beel1/RASCSI/src/rascsi152/doc/fullspec.png

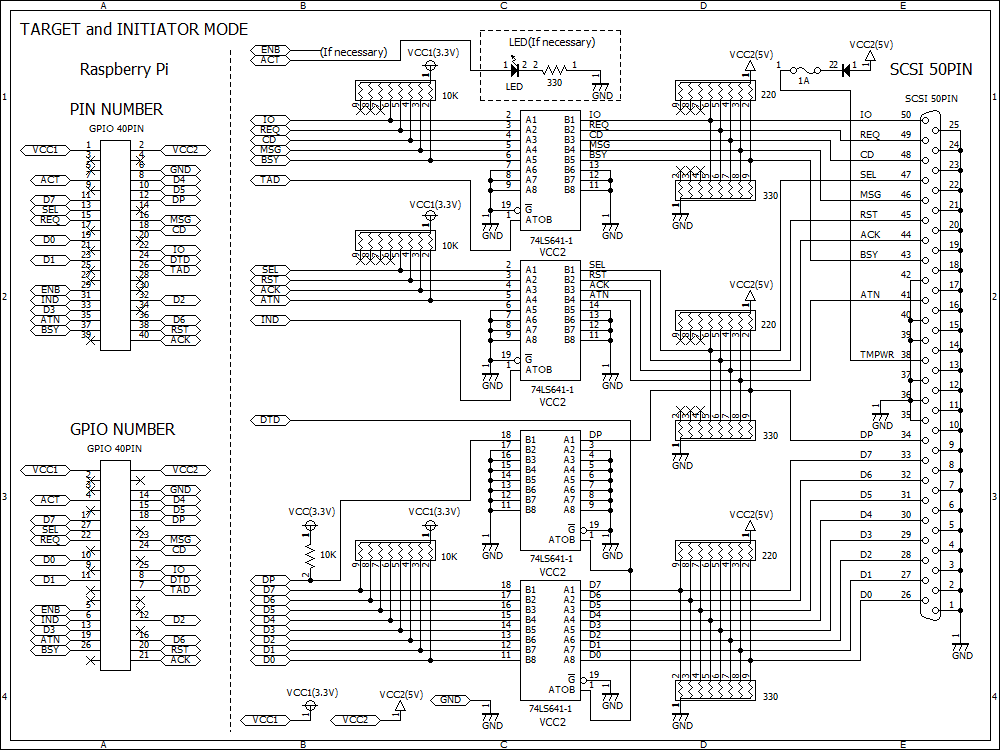
src/rascsi152/doc/fullspec.png
