beel1/RASCSI/src/rascsi152/doc/pinassign.png

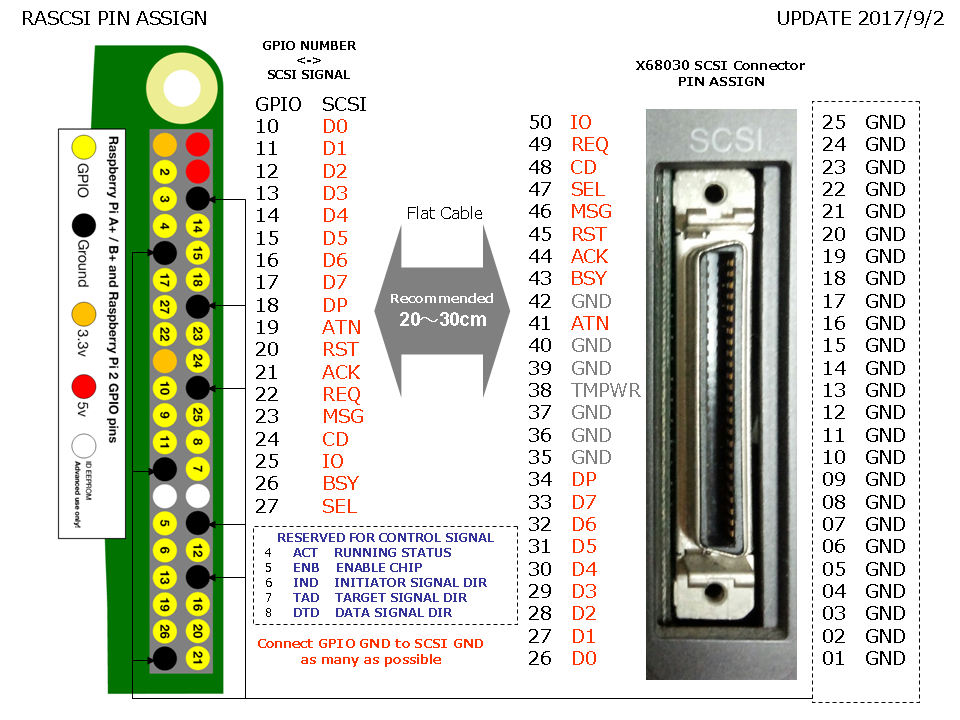
src/rascsi152/doc/pinassign.png
