beel1/RASCSI/src/rascsi152/doc/target.png

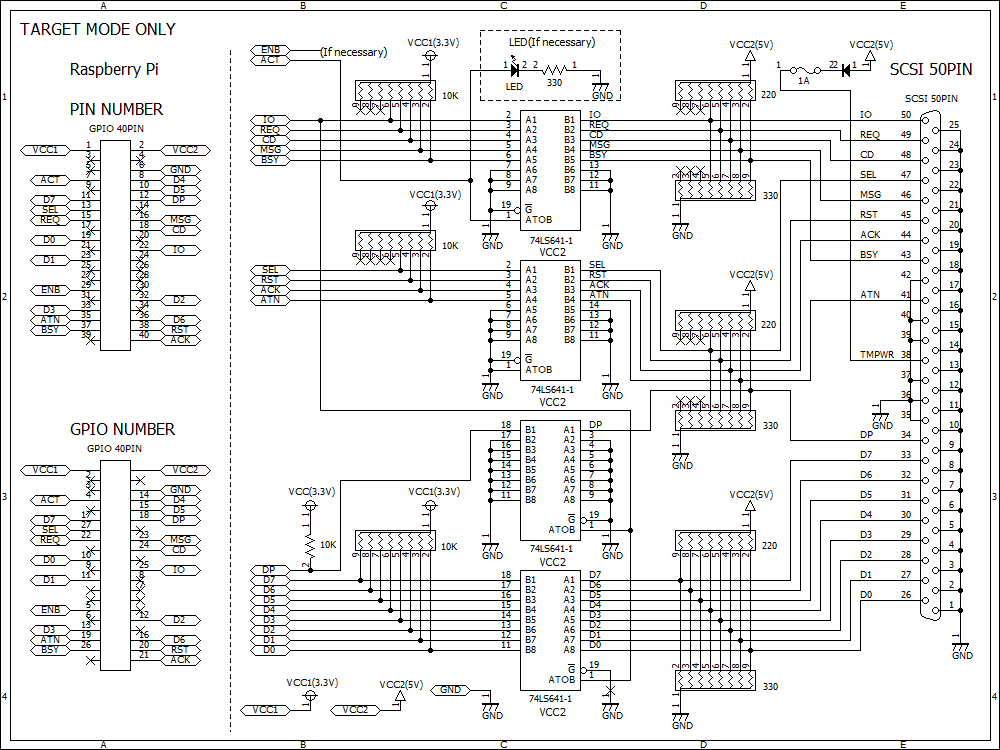
src/rascsi152/doc/target.png
