beel1/RASCSI/hw/rascsi_CN50_IDC50/rascsi_din.pdf

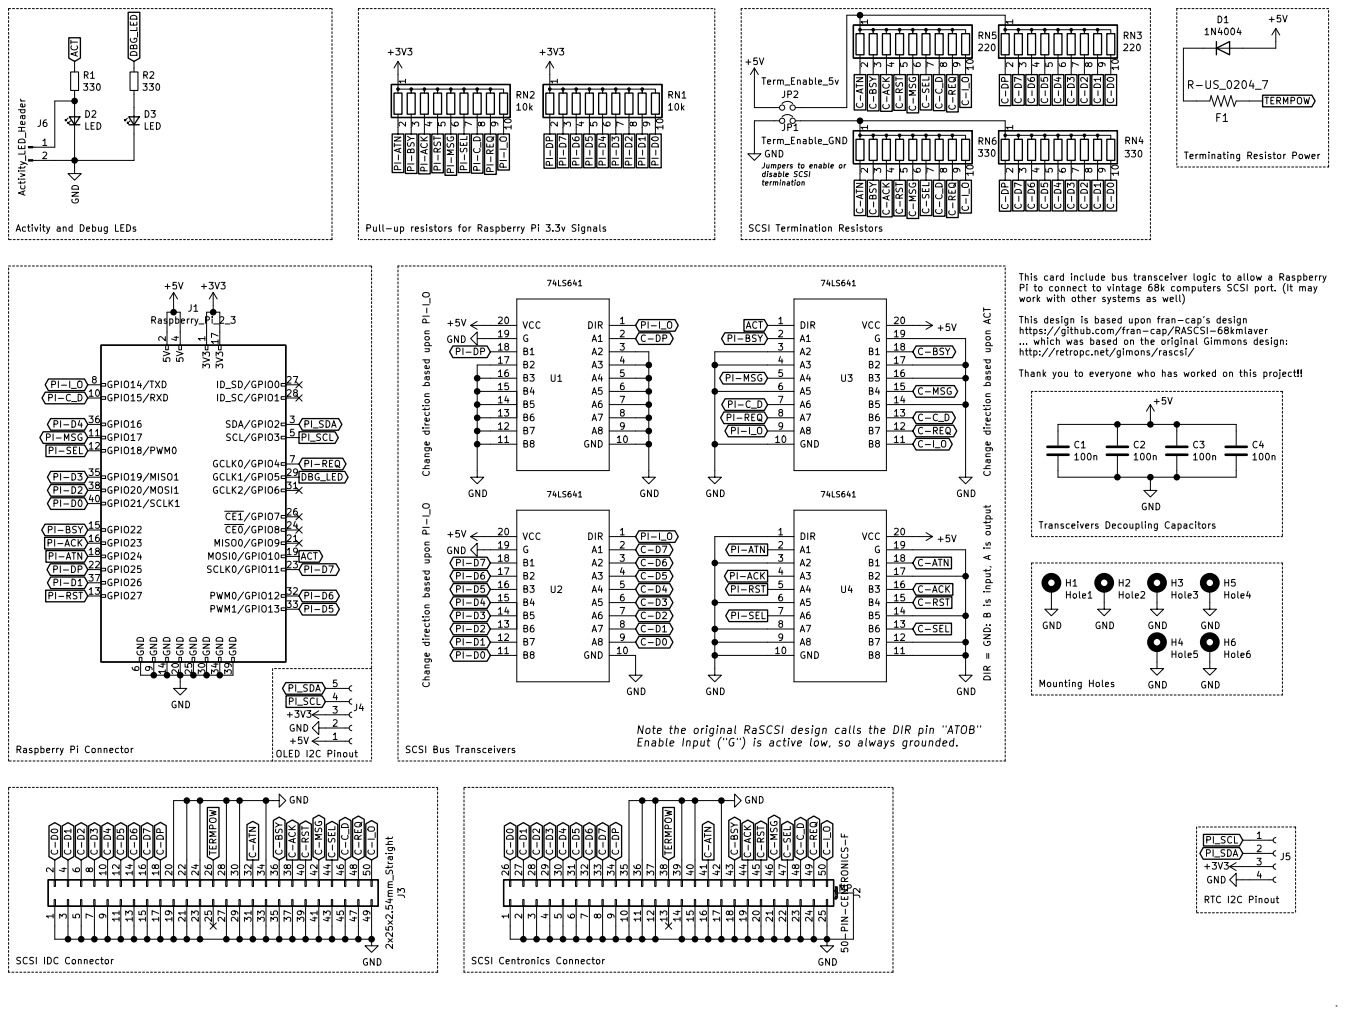
[picture p4: page 1]

Terminating Resistor Power Jumpers to enable or disable SCSI

Activity and Debug LEDs

This card include bus transceiver logic to allow a Raspberry
Pi to connect to vintage 68k computers SCSI port. (It may
work with other systems as well)

This design is based upon fran-cap's design
https://github.com/fran-cap/RASCSI-68kmlaver
... which was based on the original Gimmons design:
http://retropc.net/gimons/rascsi/

PI-MSG
ACT PI-SEL PI-ATN

Note the original RaSCSI design calls the DIR pin "ATOB"
