beel1/RASCSI/src/rascsi152/src/raspberrypi/disk.h

#define disk_h
#define DEFAULT_VERSION	RASCSI			// INQUERYのバージョン番号
#define DEFAULT_VENDER	"RASCSI"		// INQUERYのベンダ名
#define USE_LOG_OUTPUT	1				// 1:printf出力
#define USE_WAIT_CTRL	1				// 1:タイミング調整有効
#define USE_BURST_BUS	1				// 1:データバースト送受信有効
#define USE_SYNC_TRANS	0				// 1:同期転送有効
#define USE_MZ1F23_1024_SUPPORT		1	// 1:MZ-1F23(20M/セクタサイズ1024)
#define REMOVE_FIXED_SASIHD_SIZE	1	// 1:SASIHDのサイズ固定制限を解除する
#define BRIDGE_PRODUCT	"RASCSI BRIDGE"	// ブリッジデバイスの製品名
#include "filepath.h"
#include "fileio.h"
class Log
{
public:
	enum loglevel {
		Detail,							// 詳細レベル
		Normal,							// 通常レベル
		Warning,						// 警告レベル
		Debug							// デバッグレベル
	};
};
class BUS
{
public:
	enum phase_t {
		busfree,						// バスフリーフェーズ
		arbitration,					// アービトレーションフェーズ
		selection,						// セレクションフェーズ
		reselection,					// リセレクションフェーズ
		command,						// コマンドフェーズ
		execute,						// 実行フェーズ
		datain,							// データイン
		dataout,						// データアウト
		status,							// ステータスフェーズ
		msgin,							// メッセージフェーズ
		msgout,							// メッセージアウトフェーズ
		reserved						// 未使用/リザーブ
	};
	virtual BOOL FASTCALL Init() = 0;
	virtual void FASTCALL Reset() = 0;
	virtual void FASTCALL Cleanup() = 0;
	phase_t FASTCALL GetPhase()
	{
		DWORD mci;
		ASSERT(this);
		if (GetSEL()) {
			return selection;
		}
		if (!GetBSY()) {
			return busfree;
		}
		mci = GetMSG() ? 0x04 : 0x00;
		mci |= GetCD() ? 0x02 : 0x00;
		mci |= GetIO() ? 0x01 : 0x00;
		return Mci2Phase(mci);
	}
	static phase_t FASTCALL Mci2Phase(DWORD mci)
	{
		static const phase_t phase_table[8] =
		{
			dataout,
			datain,
			command,
			status,
			reserved,
			reserved,
			msgout,
			msgin
		};
		return phase_table[mci];
	}
	virtual DWORD FASTCALL Aquire() const = 0;
	virtual BOOL FASTCALL GetBSY() const = 0;
	virtual void FASTCALL SetBSY(BOOL ast) = 0;
	virtual BOOL FASTCALL GetSEL() const = 0;
	virtual void FASTCALL SetSEL(BOOL ast) = 0;
	virtual BOOL FASTCALL GetATN() const = 0;
	virtual void FASTCALL SetATN(BOOL ast) = 0;
	virtual BOOL FASTCALL GetACK() const = 0;
	virtual void FASTCALL SetACK(BOOL ast) = 0;
	virtual BOOL FASTCALL GetRST() const = 0;
	virtual void FASTCALL SetRST(BOOL ast) = 0;
	virtual BOOL FASTCALL GetMSG() const = 0;
	virtual void FASTCALL SetMSG(BOOL ast) = 0;
	virtual BOOL FASTCALL GetCD() const = 0;
	virtual void FASTCALL SetCD(BOOL ast) = 0;
	virtual BOOL FASTCALL GetIO() const = 0;
	virtual void FASTCALL SetIO(BOOL ast) = 0;
	virtual BOOL FASTCALL GetREQ() const = 0;
	virtual void FASTCALL SetREQ(BOOL ast) = 0;
	virtual BYTE FASTCALL GetDAT() const = 0;
	virtual void FASTCALL SetDAT(BYTE dat) = 0;
	virtual BOOL FASTCALL GetDP() const = 0;
#if USE_BURST_BUS == 1
	virtual int FASTCALL CommandHandShake(BYTE *buf) = 0;
	virtual int FASTCALL SendHandShake(
		BYTE *buf, int len, int syncoffset = 0) = 0;
	virtual int FASTCALL ReceiveHandShake(
		BYTE *buf, int len, int syncoffset = 0) = 0;
#endif	// USE_BURST_BUS
};
#define DISK_NOERROR		0x00000000	// NO ADDITIONAL SENSE INFO.
#define DISK_DEVRESET		0x00062900	// POWER ON OR RESET OCCURED
#define DISK_NOTREADY		0x00023a00	// MEDIUM NOT PRESENT
#define DISK_ATTENTION		0x00062800	// MEDIUM MAY HAVE CHANGED
#define DISK_PREVENT		0x00045302	// MEDIUM REMOVAL PREVENTED
#define DISK_READFAULT		0x00031100	// UNRECOVERED READ ERROR
#define DISK_WRITEFAULT		0x00030300	// PERIPHERAL DEVICE WRITE FAULT
#define DISK_WRITEPROTECT	0x00042700	// WRITE PROTECTED
#define DISK_MISCOMPARE		0x000e1d00	// MISCOMPARE DURING VERIFY
#define DISK_INVALIDCMD		0x00052000	// INVALID COMMAND OPERATION CODE
#define DISK_INVALIDLBA		0x00052100	// LOGICAL BLOCK ADDR. OUT OF RANGE
#define DISK_INVALIDCDB		0x00052400	// INVALID FIELD IN CDB
#define DISK_INVALIDLUN		0x00052500	// LOGICAL UNIT NOT SUPPORTED
#define DISK_INVALIDPRM		0x00052600	// INVALID FIELD IN PARAMETER LIST
#define DISK_INVALIDMSG		0x00054900	// INVALID MESSAGE ERROR
#define DISK_PARAMLEN		0x00051a00	// PARAMETERS LIST LENGTH ERROR
#define DISK_PARAMNOT		0x00052601	// PARAMETERS NOT SUPPORTED
#define DISK_PARAMVALUE		0x00052602	// PARAMETERS VALUE INVALID
#define DISK_PARAMSAVE		0x00053900	// SAVING PARAMETERS NOT SUPPORTED
#define DISK_NODEFECT		0x00010000	// DEFECT LIST NOT FOUND
class Disk;
class DiskTrack
{
public:
	enum {
		NumSectors = 32					// トラック毎のセクタ数
	};
	typedef struct {
		int track;						// トラックナンバー
		int size;						// セクタサイズ(8 or 9)
		int sectors;					// セクタ数(<=0x100)
		DWORD length;					// データバッファ長
		BYTE *buffer;					// データバッファ
		BOOL init;						// ロード済みか
		BOOL changed;					// 変更済みフラグ
		DWORD maplen;					// 変更済みマップ長
		BOOL *changemap;				// 変更済みマップ
		BOOL raw;						// RAWモード
		off64_t imgoffset;				// 実データまでのオフセット
	} disktrk_t;
public:
	DiskTrack();
	virtual ~DiskTrack();
	void FASTCALL Init(
		Disk *p, int track, int size, int sectors,
		BOOL raw = FALSE, off64_t imgoff = 0);
	BOOL FASTCALL Load();
	BOOL FASTCALL Save();
	BOOL FASTCALL Read(BYTE *buf, int sec) const;
	BOOL FASTCALL Write(const BYTE *buf, int sec);
	int FASTCALL GetTrack() const		{ return dt.track; }
	BOOL FASTCALL IsChanged() const		{ return dt.changed; }
private:
	Disk *disk;
	disktrk_t dt;
};
class DiskCache
{
public:
	typedef struct {
		DiskTrack *disktrk;				// 割り当てトラック
		DWORD serial;					// 最終シリアル
	} cache_t;
	enum {
		CacheMax = 16
	};
public:
	DiskCache(Disk *p, int size, int blocks, off64_t imgoff = 0);
	virtual ~DiskCache();
	void FASTCALL SetRawMode(BOOL raw);
	BOOL FASTCALL Save();
	BOOL FASTCALL Read(BYTE *buf, int block);
	BOOL FASTCALL Write(const BYTE *buf, int block);
	BOOL FASTCALL GetCache(int index, int& track, DWORD& serial) const;
private:
	void FASTCALL Clear();
	DiskTrack* FASTCALL Assign(int track);
	BOOL FASTCALL Load(int index, int track, DiskTrack *disktrk = NULL);
	void FASTCALL Update();
	Disk *disk;
	cache_t cache[CacheMax];
	DWORD serial;
	int sec_size;
	int sec_blocks;
	BOOL cd_raw;
	off64_t imgoffset;
};
class Disk
{
public:
	typedef struct {
		DWORD id;						// メディアID
		BOOL ready;						// 有効なディスク
		BOOL writep;					// 書き込み禁止
		BOOL readonly;					// 読み込み専用
		BOOL removable;					// 取り外し
		BOOL lock;						// ロック
		BOOL attn;						// アテンション
		BOOL reset;						// リセット
		int size;						// セクタサイズ
		DWORD blocks;					// 総セクタ数
		DWORD lun;						// LUN
		DWORD code;						// ステータスコード
		DiskCache *dcache;				// ディスクキャッシュ
		off64_t imgoffset;				// 実データまでのオフセット
	} disk_t;
public:
	Disk();
	virtual ~Disk();
	virtual void FASTCALL Reset();
	DWORD FASTCALL GetID() const		{ return disk.id; }
	BOOL FASTCALL IsNULL() const;
	BOOL FASTCALL IsSASI() const;
	virtual BOOL FASTCALL Open(const Filepath& path, BOOL attn = TRUE);
	void FASTCALL GetPath(Filepath& path) const;
	void FASTCALL Eject(BOOL force);
	BOOL FASTCALL IsReady() const		{ return disk.ready; }
	void FASTCALL WriteP(BOOL flag);
	BOOL FASTCALL IsWriteP() const		{ return disk.writep; }
	BOOL FASTCALL IsReadOnly() const	{ return disk.readonly; }
	BOOL FASTCALL IsRemovable() const	{ return disk.removable; }
	BOOL FASTCALL IsLocked() const		{ return disk.lock; }
	BOOL FASTCALL IsAttn() const		{ return disk.attn; }
	BOOL FASTCALL Flush();
	void FASTCALL GetDisk(disk_t *buffer) const;
	void FASTCALL SetLUN(DWORD lun)		{ disk.lun = lun; }
	DWORD FASTCALL GetLUN()				{ return disk.lun; }
	virtual int FASTCALL Inquiry(const DWORD *cdb, BYTE *buf, DWORD major, DWORD minor);
	virtual int FASTCALL RequestSense(const DWORD *cdb, BYTE *buf);
	int FASTCALL SelectCheck(const DWORD *cdb);
	int FASTCALL SelectCheck10(const DWORD *cdb);
	virtual BOOL FASTCALL ModeSelect(const DWORD *cdb, const BYTE *buf, int length);
	virtual int FASTCALL ModeSense(const DWORD *cdb, BYTE *buf);
	virtual int FASTCALL ModeSense10(const DWORD *cdb, BYTE *buf);
	int FASTCALL ReadDefectData10(const DWORD *cdb, BYTE *buf);
	virtual BOOL FASTCALL TestUnitReady(const DWORD *cdb);
	BOOL FASTCALL Rezero(const DWORD *cdb);
	BOOL FASTCALL Format(const DWORD *cdb);
	BOOL FASTCALL Reassign(const DWORD *cdb);
	virtual int FASTCALL Read(BYTE *buf, DWORD block);
	int FASTCALL WriteCheck(DWORD block);
	BOOL FASTCALL Write(const BYTE *buf, DWORD block);
	BOOL FASTCALL Seek(const DWORD *cdb);
	BOOL FASTCALL Assign(const DWORD *cdb);
	BOOL FASTCALL Specify(const DWORD *cdb);
	BOOL FASTCALL StartStop(const DWORD *cdb);
	BOOL FASTCALL SendDiag(const DWORD *cdb);
	BOOL FASTCALL Removal(const DWORD *cdb);
	int FASTCALL ReadCapacity(const DWORD *cdb, BYTE *buf);
	BOOL FASTCALL Verify(const DWORD *cdb);
	virtual int FASTCALL ReadToc(const DWORD *cdb, BYTE *buf);
	virtual BOOL FASTCALL PlayAudio(const DWORD *cdb);
	virtual BOOL FASTCALL PlayAudioMSF(const DWORD *cdb);
	virtual BOOL FASTCALL PlayAudioTrack(const DWORD *cdb);
	void FASTCALL InvalidCmd()			{ disk.code = DISK_INVALIDCMD; }
	BOOL FASTCALL IsCacheWB() { return cache_wb; }
	void FASTCALL SetCacheWB(BOOL enable) { cache_wb = enable; }
	Fileio* FASTCALL GetFio() { return &fio; };
protected:
	virtual int FASTCALL AddError(BOOL change, BYTE *buf);
	virtual int FASTCALL AddFormat(BOOL change, BYTE *buf);
	virtual int FASTCALL AddDrive(BOOL change, BYTE *buf);
	int FASTCALL AddOpt(BOOL change, BYTE *buf);
	int FASTCALL AddCache(BOOL change, BYTE *buf);
	int FASTCALL AddCDROM(BOOL change, BYTE *buf);
	int FASTCALL AddCDDA(BOOL change, BYTE *buf);
	virtual int FASTCALL AddVendor(int page, BOOL change, BYTE *buf);
	BOOL FASTCALL CheckReady();
	disk_t disk;
	Filepath diskpath;
	BOOL cache_wb;
	Fileio fio;
};
class SASIHD : public Disk
{
public:
	SASIHD();
	void FASTCALL Reset();
	BOOL FASTCALL Open(const Filepath& path, BOOL attn = TRUE);
	int FASTCALL RequestSense(const DWORD *cdb, BYTE *buf);
};
class SCSIHD : public Disk
{
public:
	SCSIHD();
	void FASTCALL Reset();
	BOOL FASTCALL Open(const Filepath& path, BOOL attn = TRUE);
	int FASTCALL Inquiry(
		const DWORD *cdb, BYTE *buf, DWORD major, DWORD minor);
	BOOL FASTCALL ModeSelect(const DWORD *cdb, const BYTE *buf, int length);
};
class SCSIHD_NEC : public SCSIHD
{
public:
	SCSIHD_NEC();
	BOOL FASTCALL Open(const Filepath& path, BOOL attn = TRUE);
	int FASTCALL Inquiry(
		const DWORD *cdb, BYTE *buf, DWORD major, DWORD minor);
	int FASTCALL AddError(BOOL change, BYTE *buf);
	int FASTCALL AddFormat(BOOL change, BYTE *buf);
	int FASTCALL AddDrive(BOOL change, BYTE *buf);
private:
	int cylinders;
	int heads;
	int sectors;
	int sectorsize;
	off64_t imgoffset;
	off64_t imgsize;
};
class SCSIHD_APPLE : public SCSIHD
{
public:
	SCSIHD_APPLE();
	int FASTCALL Inquiry(
		const DWORD *cdb, BYTE *buf, DWORD major, DWORD minor);
	int FASTCALL AddVendor(int page, BOOL change, BYTE *buf);
};
class SCSIMO : public Disk
{
public:
	SCSIMO();
	BOOL FASTCALL Open(const Filepath& path, BOOL attn = TRUE);
	int FASTCALL Inquiry(const DWORD *cdb, BYTE *buf, DWORD major, DWORD minor);
	BOOL FASTCALL ModeSelect(const DWORD *cdb, const BYTE *buf, int length);
	int FASTCALL AddVendor(int page, BOOL change, BYTE *buf);
};
class SCSICD;
class CDTrack
{
public:
	CDTrack(SCSICD *scsicd);
	virtual ~CDTrack();
	BOOL FASTCALL Init(int track, DWORD first, DWORD last);
	void FASTCALL SetPath(BOOL cdda, const Filepath& path);
	void FASTCALL GetPath(Filepath& path) const;
	void FASTCALL AddIndex(int index, DWORD lba);
	DWORD FASTCALL GetFirst() const;
	DWORD FASTCALL GetLast() const;
	DWORD FASTCALL GetBlocks() const;
	int FASTCALL GetTrackNo() const;
	BOOL FASTCALL IsValid(DWORD lba) const;
	BOOL FASTCALL IsAudio() const;
private:
	SCSICD *cdrom;
	BOOL valid;
	int track_no;
	DWORD first_lba;
	DWORD last_lba;
	BOOL audio;
	BOOL raw;
	Filepath imgpath;
};
class CDDABuf
{
public:
	CDDABuf();
	virtual ~CDDABuf();
};
class SCSICD : public Disk
{
public:
	enum {
		TrackMax = 96					// トラック最大数
	};
public:
	SCSICD();
	virtual ~SCSICD();
	BOOL FASTCALL Open(const Filepath& path, BOOL attn = TRUE);
	int FASTCALL Inquiry(const DWORD *cdb, BYTE *buf, DWORD major, DWORD minor);
	int FASTCALL Read(BYTE *buf, DWORD block);
	int FASTCALL ReadToc(const DWORD *cdb, BYTE *buf);
	BOOL FASTCALL PlayAudio(const DWORD *cdb);
	BOOL FASTCALL PlayAudioMSF(const DWORD *cdb);
	BOOL FASTCALL PlayAudioTrack(const DWORD *cdb);
	BOOL FASTCALL NextFrame();
	void FASTCALL GetBuf(DWORD *buffer, int samples, DWORD rate);
	void FASTCALL LBAtoMSF(DWORD lba, BYTE *msf) const;
	DWORD FASTCALL MSFtoLBA(const BYTE *msf) const;
private:
	BOOL FASTCALL OpenCue(const Filepath& path);
	BOOL FASTCALL OpenIso(const Filepath& path);
	BOOL FASTCALL OpenPhysical(const Filepath& path);
	BOOL rawfile;
	void FASTCALL ClearTrack();
	int FASTCALL SearchTrack(DWORD lba) const;
	CDTrack* track[TrackMax];
	int tracks;
	int dataindex;
	int audioindex;
	int frame;
};
class SCSIBR : public Disk
{
public:
	SCSIBR();
	virtual ~SCSIBR();
	int FASTCALL Inquiry(
		const DWORD *cdb, BYTE *buf, DWORD major, DWORD minor);
	BOOL FASTCALL TestUnitReady(const DWORD *cdb);
	int FASTCALL GetMessage10(const DWORD *cdb, BYTE *buf);
	int FASTCALL SendMessage10(const DWORD *cdb, BYTE *buf);
	typedef int (*MsgFunc)(BOOL read, int func, int phase, int len, BYTE *);
	void FASTCALL SetMsgFunc(int type, MsgFunc f);
private:
	MsgFunc pMsgFunc[8];
};
class SASIDEV
{
public:
	enum {
		UnitMax = 8
	};
#if USE_WAIT_CTRL == 1
	enum {
		min_status_time =	20,
		min_exec_time =		100,
		min_data_time =		200
	};
#endif	// USE_WAIT_CTRL
	typedef struct {
		BUS::phase_t phase;				// 遷移フェーズ
		int id;							// コントローラID(0-7)
		BUS *bus;						// バス
		DWORD cmd[10];					// コマンドデータ
		DWORD status;					// ステータスデータ
		DWORD message;					// メッセージデータ
#if USE_WAIT_CTRL == 1
		DWORD execstart;				// 実行開始時間
#endif	// USE_WAIT_CTRL
		BYTE *buffer;					// 転送バッファ
		int bufsize;					// 転送バッファサイズ
		DWORD blocks;					// 転送ブロック数
		DWORD next;						// 次のレコード
		DWORD offset;					// 転送オフセット
		DWORD length;					// 転送残り長さ
		Disk *unit[UnitMax];
	} ctrl_t;
public:
	SASIDEV();
	virtual ~SASIDEV();
	virtual void FASTCALL Reset();
	virtual BUS::phase_t FASTCALL Process();
	void FASTCALL Connect(int id, BUS *sbus);
	Disk* FASTCALL GetUnit(int no);
	void FASTCALL SetUnit(int no, Disk *dev);
	BOOL FASTCALL HasUnit();
	BUS::phase_t FASTCALL GetPhase() {return ctrl.phase;}
	int FASTCALL GetID() {return ctrl.id;}
	void FASTCALL GetCTRL(ctrl_t *buffer);
	ctrl_t* FASTCALL GetWorkAddr() { return &ctrl; }
	virtual BOOL FASTCALL IsSASI() const {return TRUE;}
	virtual BOOL FASTCALL IsSCSI() const {return FALSE;}
	Disk* FASTCALL GetBusyUnit();
protected:
	virtual void FASTCALL BusFree();
	virtual void FASTCALL Selection();
	virtual void FASTCALL Command();
	virtual void FASTCALL Execute();
	void FASTCALL Status();
	void FASTCALL MsgIn();
	void FASTCALL DataIn();
	void FASTCALL DataOut();
	virtual void FASTCALL Error();
	void FASTCALL CmdTestUnitReady();
	void FASTCALL CmdRezero();
	void FASTCALL CmdRequestSense();
	void FASTCALL CmdFormat();
	void FASTCALL CmdReassign();
	void FASTCALL CmdRead6();
	void FASTCALL CmdWrite6();
	void FASTCALL CmdSeek6();
	void FASTCALL CmdAssign();
	void FASTCALL CmdSpecify();
	void FASTCALL CmdInvalid();
	virtual void FASTCALL Send();
	virtual void FASTCALL SendNext();
	virtual void FASTCALL Receive();
	virtual void FASTCALL ReceiveNext();
#if USE_BURST_BUS == 1
	virtual void FASTCALL SendBurst();
	virtual void FASTCALL ReceiveBurst();
#endif	// USE_BURST_BUS
	BOOL FASTCALL XferIn(BYTE* buf);
	BOOL FASTCALL XferOut(BOOL cont);
	void FASTCALL FlushUnit();
	void FASTCALL Log(Log::loglevel level, const char *format, ...);
protected:
	ctrl_t ctrl;
};
class SCSIDEV : public SASIDEV
{
public:
	typedef struct {
		BOOL syncenable;				// 同期転送可能
		int syncperiod;					// 同期転送ピリオド
		int syncoffset;					// 同期転送オフセット
		BOOL atnmsg;
		int msc;
		BYTE msb[256];
	} scsi_t;
	enum {
		SYNCPERIOD = 50,
		SYNCOFFSET = 16
	};
public:
	SCSIDEV();
	void FASTCALL Reset();
	BUS::phase_t FASTCALL Process();
	BOOL FASTCALL IsSASI() const {return FALSE;}
	BOOL FASTCALL IsSCSI() const {return TRUE;}
private:
	void FASTCALL BusFree();
	void FASTCALL Selection();
	void FASTCALL Execute();
	void FASTCALL MsgOut();
	void FASTCALL Error();
	void FASTCALL CmdInquiry();
	void FASTCALL CmdModeSelect();
	void FASTCALL CmdModeSense();
	void FASTCALL CmdStartStop();
	void FASTCALL CmdSendDiag();
	void FASTCALL CmdRemoval();
	void FASTCALL CmdReadCapacity();
	void FASTCALL CmdRead10();
	void FASTCALL CmdWrite10();
	void FASTCALL CmdSeek10();
	void FASTCALL CmdVerify();
	void FASTCALL CmdSynchronizeCache();
	void FASTCALL CmdReadDefectData10();
	void FASTCALL CmdReadToc();
	void FASTCALL CmdPlayAudio10();
	void FASTCALL CmdPlayAudioMSF();
	void FASTCALL CmdPlayAudioTrack();
	void FASTCALL CmdModeSelect10();
	void FASTCALL CmdModeSense10();
	void FASTCALL CmdGetMessage10();
	void FASTCALL CmdSendMessage10();
	void FASTCALL Send();
	void FASTCALL SendNext();
	void FASTCALL Receive();
	void FASTCALL ReceiveNext();
#if USE_BURST_BUS == 1
	void FASTCALL SendBurst();
	void FASTCALL ReceiveBurst();
#endif	// USE_BURST_BUS
	BOOL FASTCALL XferMsg(DWORD msg);
	scsi_t scsi;
};
