beel1/RASCSI/(commit log)

2021-11-07 Fix issue 422 (#425)
    * Use the effective filename when checking for duplicates
    * Fixed check for asynchronous notifications
    * Added additional filename check
    * Applied fix also for attach
    [rascsi.cpp]
2021-11-08 DaynaPort: Ignore commands with a bogus control value (#433)
    All traffic from the DaynaPort will have a control value of 0xc0 or
    0x80, so any commands that don't should be ignored.
    This helps the Mac Plus which will try to READ(6) from the DaynaPort
    device if it's attached at boot and then try to interpret the
    ethernet packet as hard drive data and crash.
    See issue akuker#419
2021-11-08 DaynaPort: Remove scsi_cmd_read_6_t struct, it was not correct (#435)
    The DWORDs in `cdb *` are not raw packed data from the wire, they
    are manually copied in a previous function. Trying to cast that
    unpacked, aligned-on-byte-boundary data into the packed
    scsi_cmd_read_6_t structure is not correct and does not put the
    correct DWORDs into the proper fields.
    Just do away with this struct and refer to the 2 cdb DWORDs (opcode
    and length) manually.
2021-11-13 Add Centronics 50 RaSCSI Target board
    Based on /RASCSI/hw/rascsi_1p6/ using only through-hole components
    Centronics 50 (SCSI-1) footprint based on SparkFun connectors library
    CAD software is KiCAD 5.1.6-1
    Non-standard GPIO pins assignment
    Added headers for I2C RTC module and front panel ACTivity LED
    [rascsi_din-B_Mask.gbr, rascsi_din-B_SilkS.gbr, rascsi_din-Bottom.gbr, rascsi_din-Edge_Cuts.gbr, rascsi_din-F_Mask.gbr, rascsi_din-F_SilkS.gbr, rascsi_din-NPTH.drl, rascsi_din-PTH.drl]
2021-11-14 Add Centronics 50 target board BOM
    [rascsi_din.csv]
