beel1/RASCSI/(notices)

Notices in the files:
src/rascsi152/src/raspberrypi/disk.h:
Copyright (C) 2001-2006 PI.(Twitter:@xm6_original)
Copyright (C) 2014-2021 GIMONS(Twitter:@kugimoto0715)
Copyright (C) 2010-2015 isaki@NetBSD.org
